zainmfd/FightFire/README.md

# FightFire

Fight Fire is a wildfire prediction device that will help the firefighting authority to respond quickly to the wildfire.  
[Click here for more details](https://zainmfd.github.io/FightFire/)
