zainmfd/FightFire/docs/index.md

    
# **<p style="text-align:center;">Fight Fire</p>**
Fight Fire is a wildfire prediction device that will help the firefighting authority to respond quickly to the wildfire.  
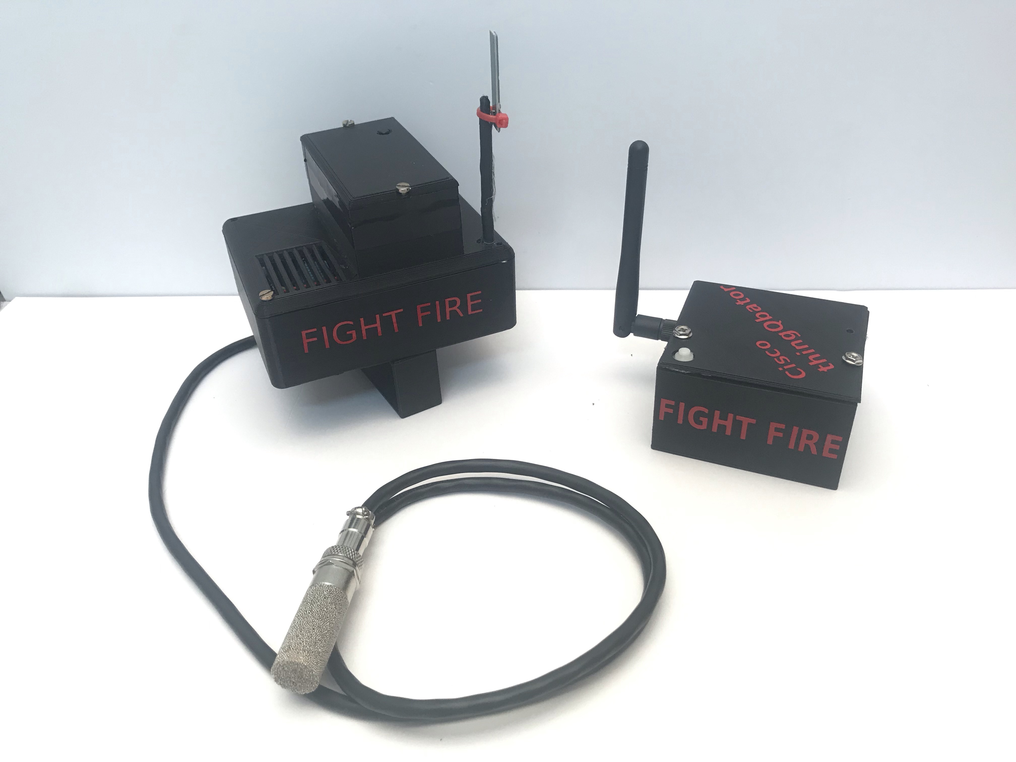
[picture p1: docs/img/28.jpg]
Fight Fire
