zainmfd/FightFire/docs/Existing-system.md

# Existing system  
The current system of forest firefighting is preventive & monitoring in nature. The major Prevention method of wildfire is Firebreak.
  
   Firebreak

Firebreak is a gap in vegetation or other combustible material that acts as a barrier to slow or stop the progress of a bushfire or wildfire. A firebreak may occur naturally where there is a lack of vegetation or "fuel", such as a river, lake, or canyon. Firebreaks may also be man-made, and many of these also serve as roads, such as a logging road, four-wheel drive trail, secondary road, or a highway.

Satellites are used for wild fire monitoring.NASA’s satellite instruments are often the first to detect wildfires burning in remote regions, and the locations of new fires are sent directly to land managers worldwide within hours of the satellite overpass. Together, NASA instruments, including a number built and managed by NASA’s Jet Propulsion Laboratory in Pasadena, California, detect actively burning fires, track the transport of smoke from fires, provide information for fire management, and map the extent of changes to ecosystems, based on the extent and severity of burn scars.
[Monitoring system](https://firms.modaps.eosdis.nasa.gov/map/#d:2020-12-07..2020-12-08;@0.0,0.0,3z)
[Source](https://www.nasa.gov/mission_pages/fires/main/missions/index.html)
