zainmfd/FightFire/docs/img/22.png

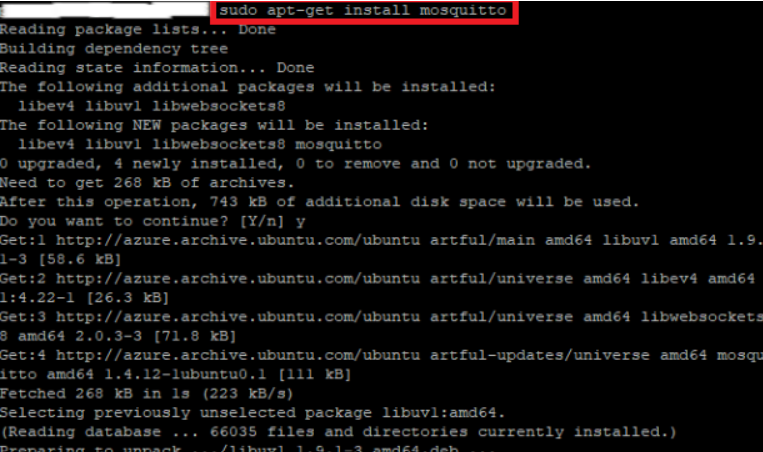
docs/img/22.png
