zainmfd/FightFire/docs/img/23.png

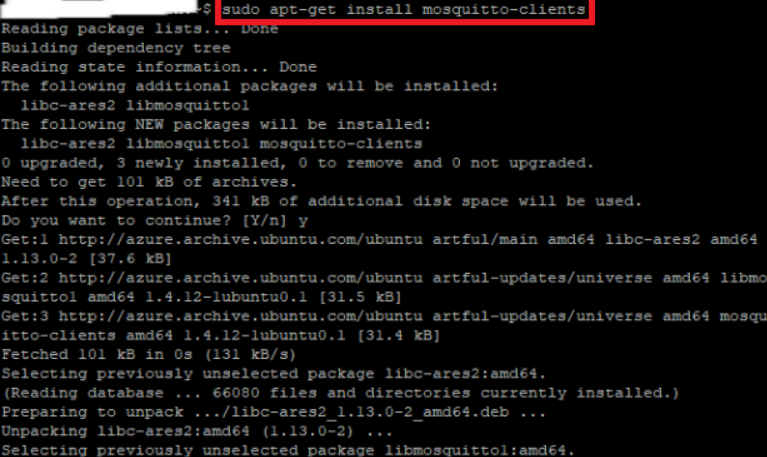
docs/img/23.png
