zainmfd/FightFire/docs/img/24.png

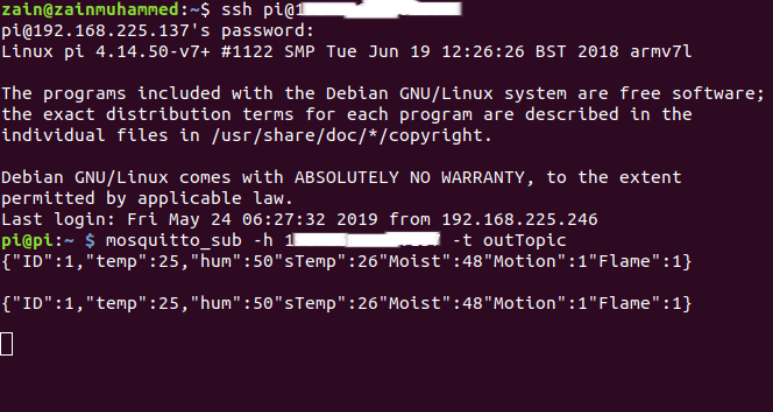
docs/img/24.png
