zainmfd/FightFire/docs/img/25.png

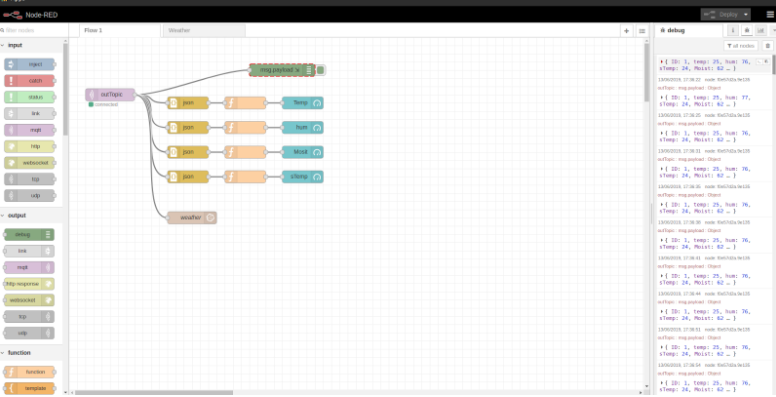
docs/img/25.png
