zainmfd/FightFire/docs/img/26.png

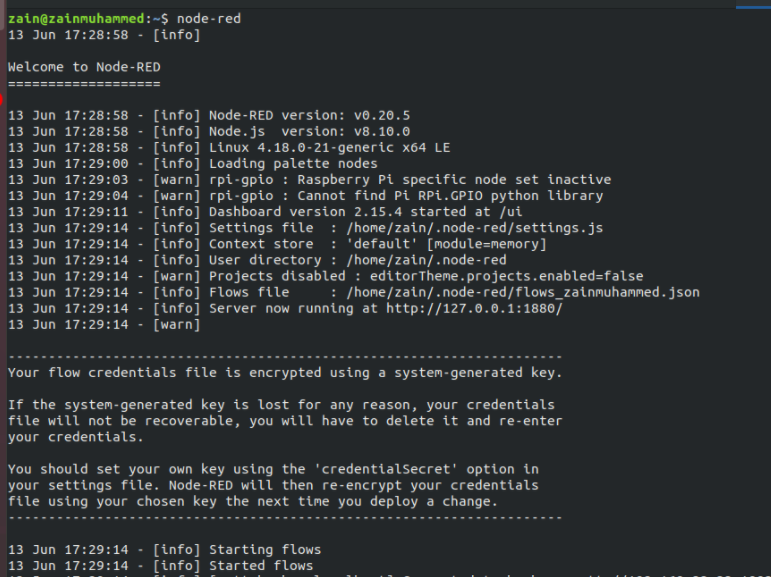
docs/img/26.png
