zainmfd/FightFire/docs/img/27.png

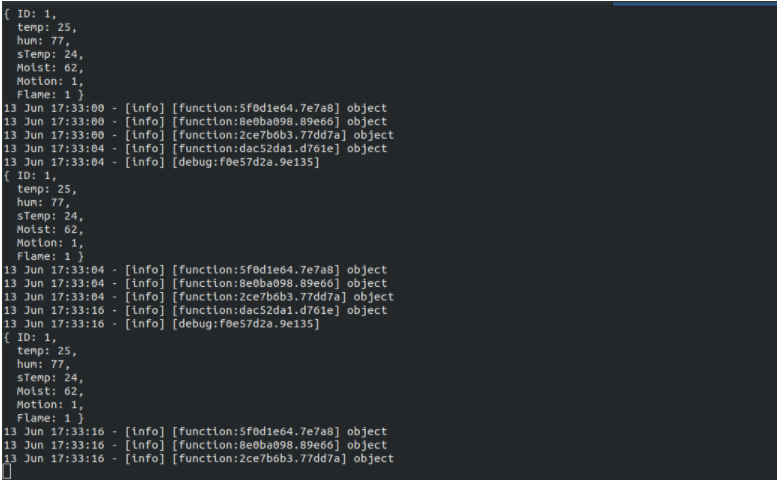
docs/img/27.png
