zainmfd/FightFire/docs/img/29.png

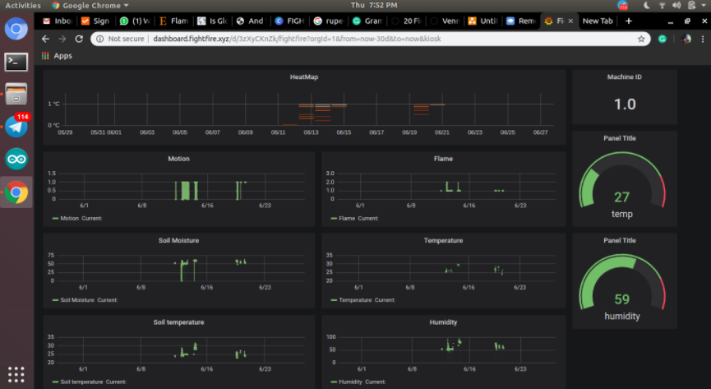
docs/img/29.png
