zainmfd/FightFire/docs/img/32.png

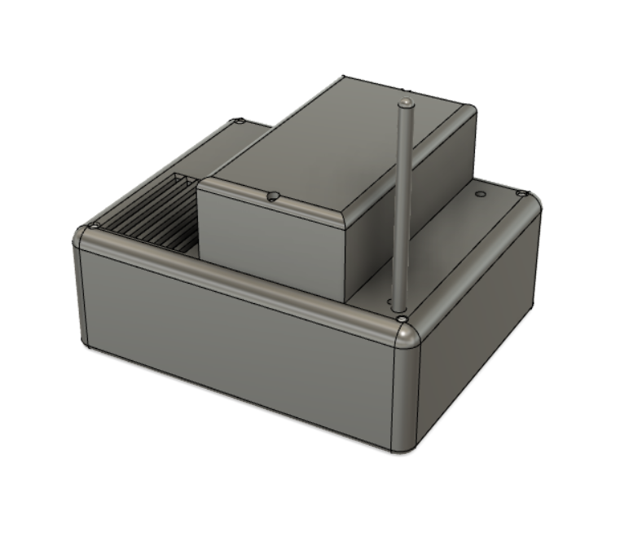
docs/img/32.png
