zainmfd/FightFire/docs/img/33.png

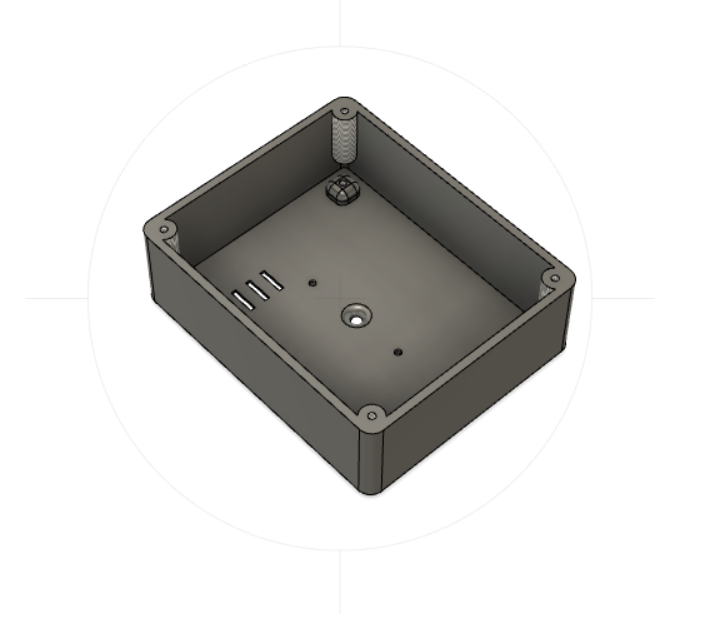
docs/img/33.png
