zainmfd/FightFire/docs/img/zain.jpg

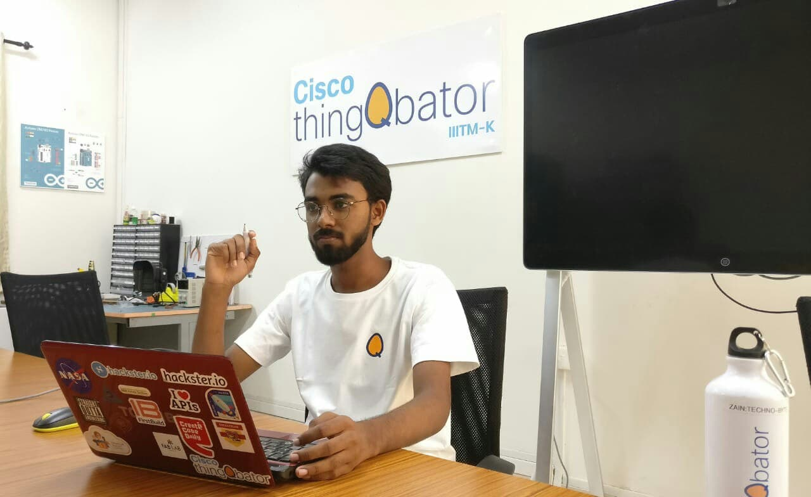
docs/img/zain.jpg
