zainmfd/FightFire/fightfire_gateway.ino

#include <SPI.h>
#include <LoRa.h>
#include <PubSubClient.h>
#include <WiFi.h>

#define ss 5
#define rst 14
#define dio0 2

const char* mqtt_server = "************"; //mqtt server
const char* ssid = "************";
const char* password = "***********";
WiFiClient espClient;
PubSubClient client(espClient);
long lastMsg = 0;
char msg[50];
int value = 0;

void setup_wifi() {

  delay(10);
  Serial.println();
  Serial.print("Connecting to ");
  Serial.println(ssid);

  WiFi.begin(ssid, password);

  while (WiFi.status() != WL_CONNECTED) {
    delay(500);
    Serial.print(".");
  }

  randomSeed(micros());

  Serial.println("");
  Serial.println("WiFi connected");
  Serial.println("IP address: ");
  Serial.println(WiFi.localIP());
}

void callback(char* topic, byte* payload, unsigned int length) {
  Serial.print("Message arrived [");
  Serial.print(topic);
  Serial.print("] ");
  for (int i = 0; i < length; i++) {
  Serial.print((char)payload[i]);
  }
  Serial.println();


}

void reconnect() {
  // Loop until we're reconnected
  while (!client.connected()) {
    Serial.print("Attempting MQTT connection...");
    // Create a random client ID
    String clientId = "ESP8266Client-";
    clientId += String(random(0xffff), HEX);
    // Attempt to connect
    if (client.connect(clientId.c_str())) {
      Serial.println("connected");
      // Once connected, publish an announcement...
//      client.publish("outTopic", "hello world");
      // ... and resubscribe
      client.subscribe("inTopic");
    } else {
      Serial.print("failed, rc=");
      Serial.print(client.state());
      Serial.println(" try again in 5 seconds");
      // Wait 5 seconds before retrying
      delay(5000);
    }
  }
}

void setup() {

  while (!Serial);
  Serial.println("LoRa Receiver");

  LoRa.setPins(ss, rst, dio0);

  while (!LoRa.begin(915E6)) {
    Serial.println(".");
    delay(500);
  }
  LoRa.setSyncWord(0xF3);
  Serial.println("LoRa Initializing OK!");

  Serial.begin(9600);
  setup_wifi();
  client.setServer(mqtt_server, 1883);
  client.setCallback(callback);
}
char charBuf[100];
void loop() {

  if (!client.connected()) {
    reconnect();
  }
  client.loop();

  int packetSize = LoRa.parsePacket();
  if (packetSize) {
    // received a packet
    Serial.print("Received packet '");

    // read packet
    while (LoRa.available()) {
      String LoRaData = LoRa.readString();
      Serial.print(LoRaData);
      LoRaData.toCharArray(charBuf, 100);

      client.publish("*********", charBuf); // type topic name
    }
    //char charBuf[50];


    // print RSSI of packet
    Serial.print("' with RSSI ");
    Serial.println(LoRa.packetRssi());
  }
}
