zainmfd/FightFire/(commit log)

2020-12-10 add de merits of existing solution
2020-12-10 Fix the error in table of lora and esp32
2020-12-10 Fix the error in table of lora and esp32 second time
